w0rxbend/ErgoDox-pcb/hw/ergodox-rp2040/left/ergodox-rp2040-left.kicad_pcb

## KiCad design hw/ergodox-rp2040/left/ergodox-rp2040-left.kicad_pcb (2026-11-14)

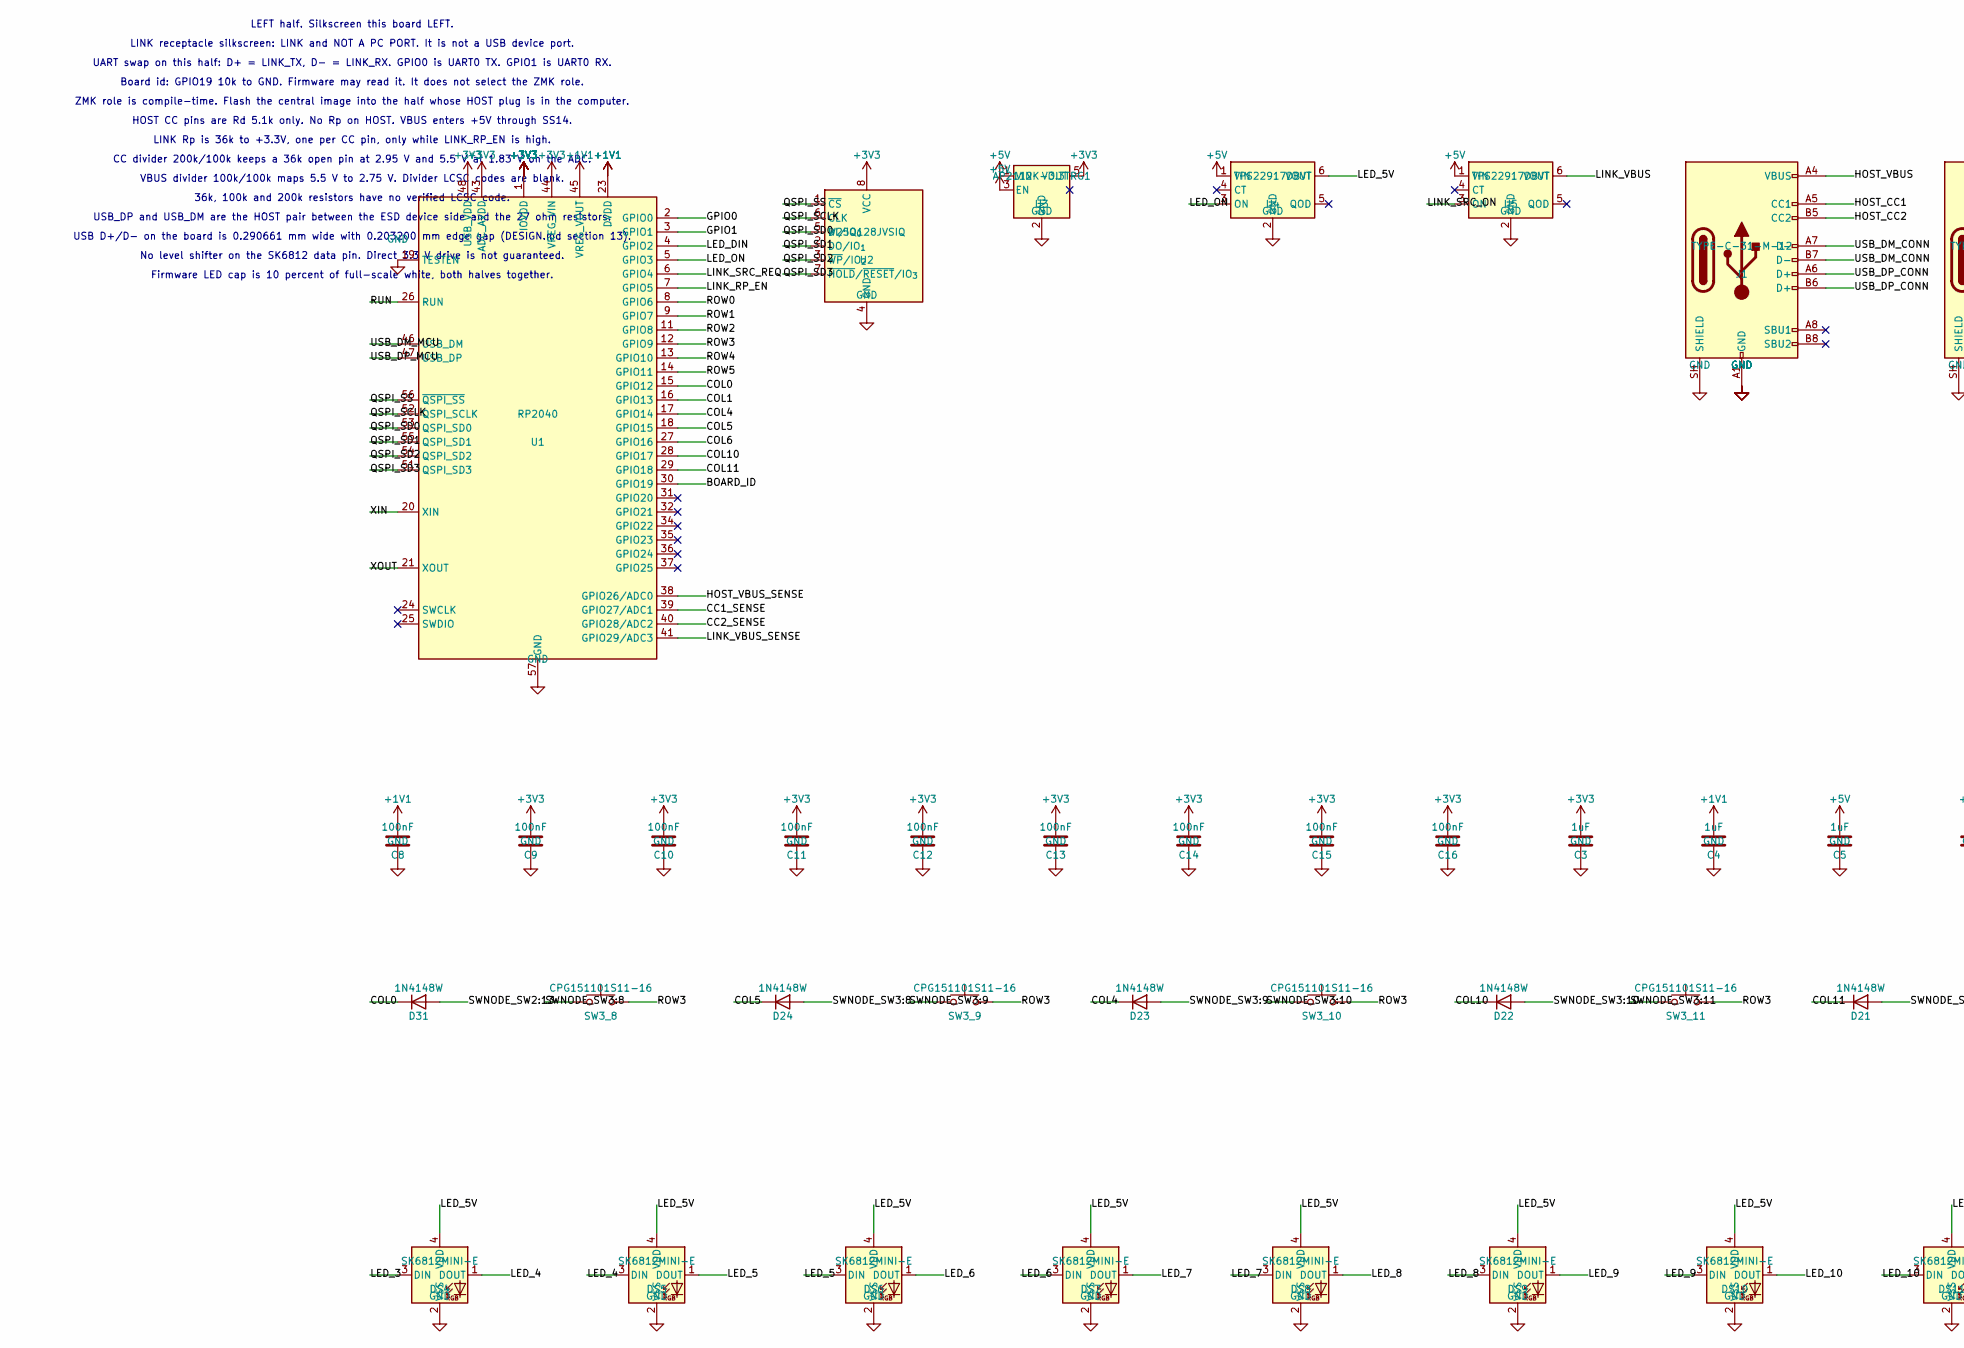
[picture p3: schematic ergodox-rp2040-left.kicad_sch, ErgoDox RP2040 left, part in row 1, column 1]

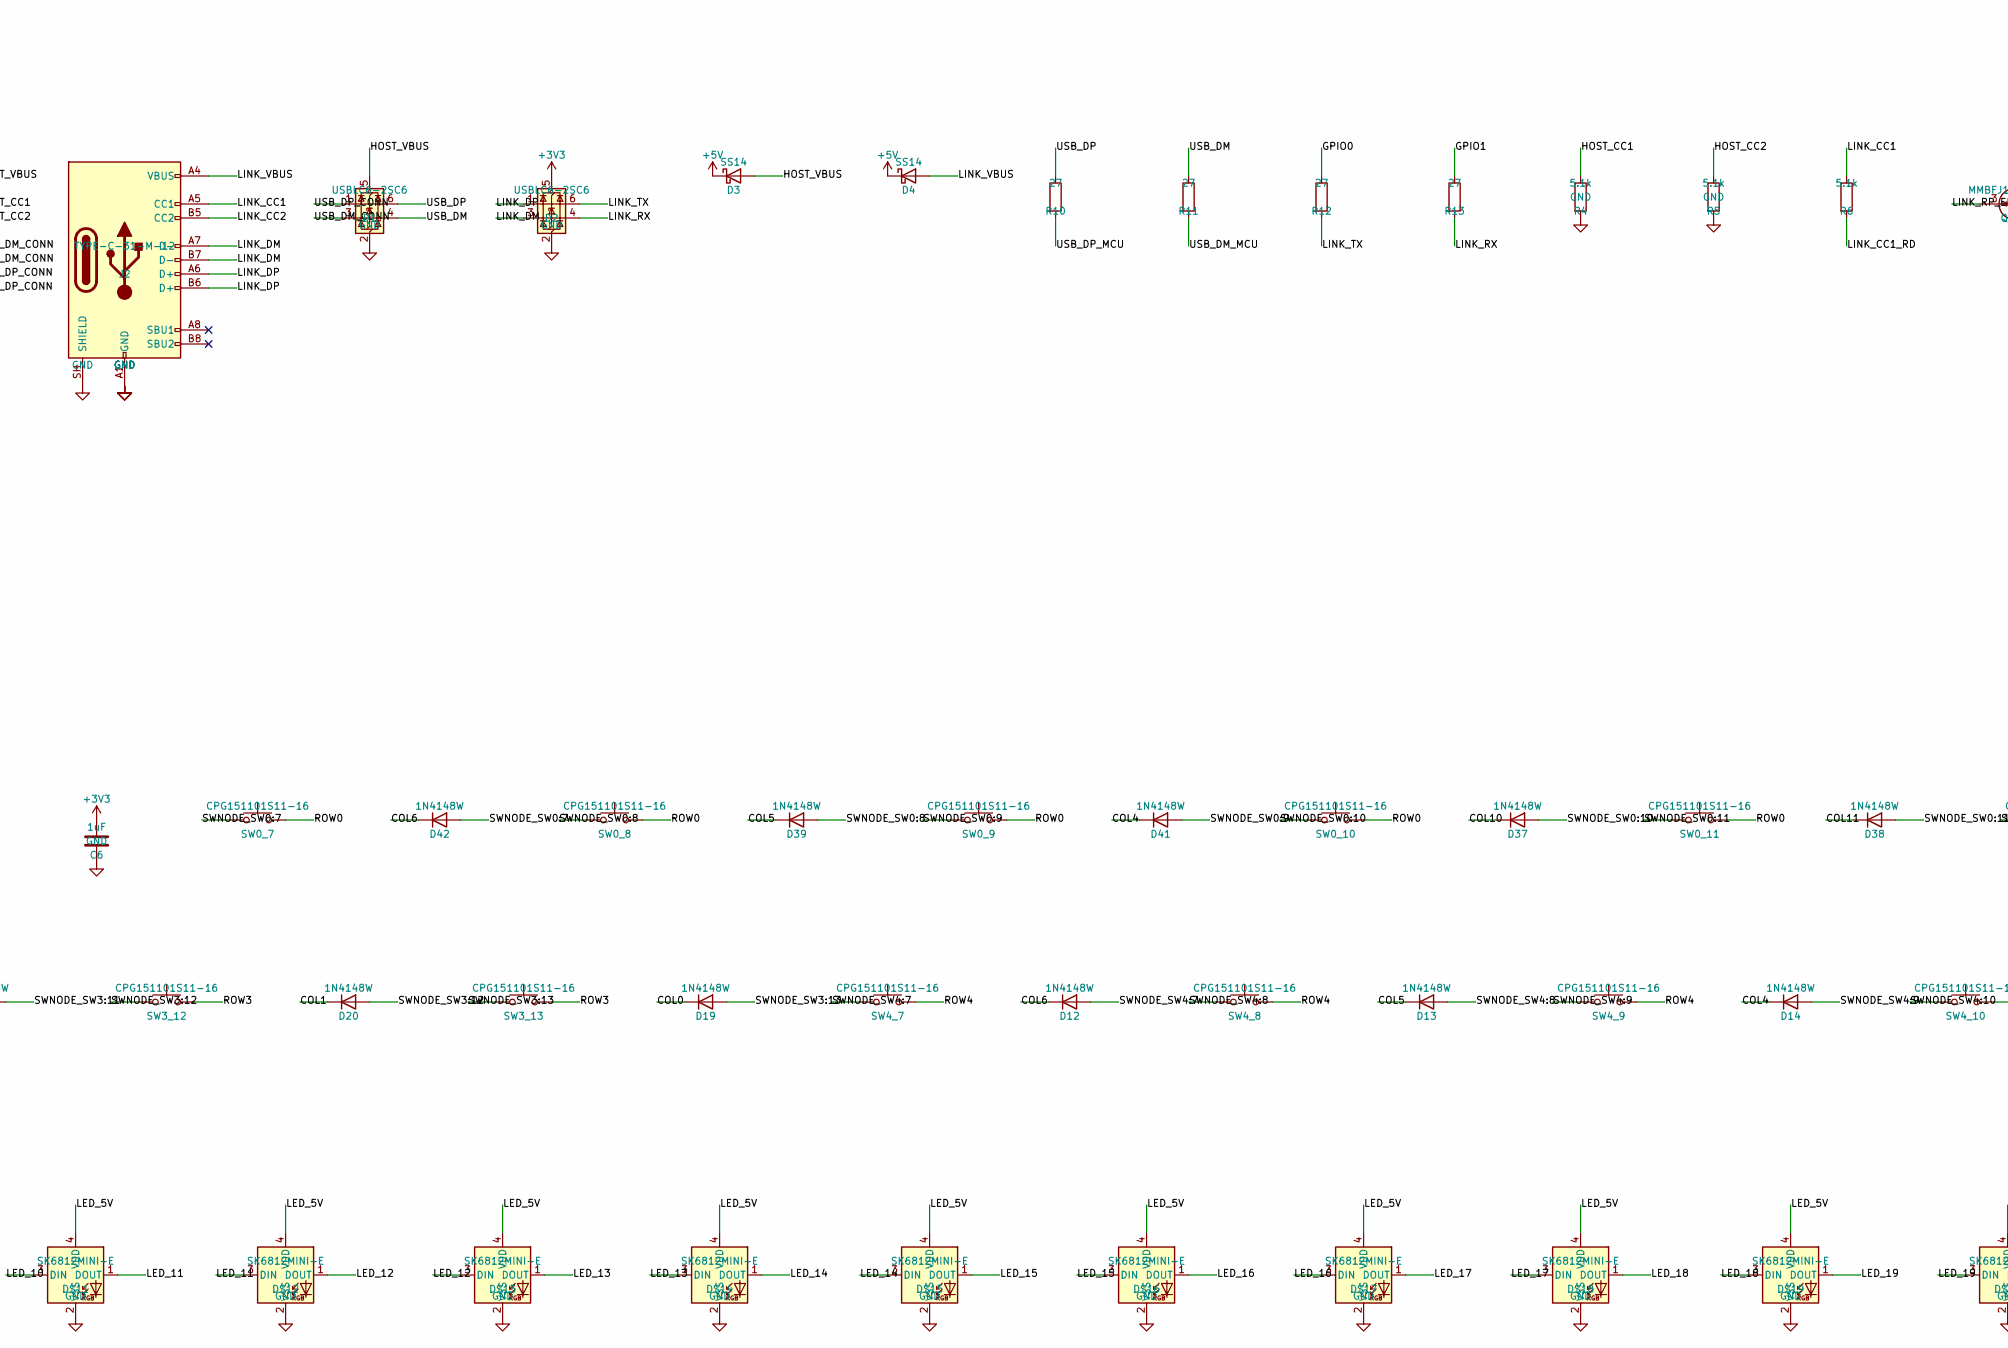
[picture p4: schematic ergodox-rp2040-left.kicad_sch, ErgoDox RP2040 left, part in row 1, column 2]

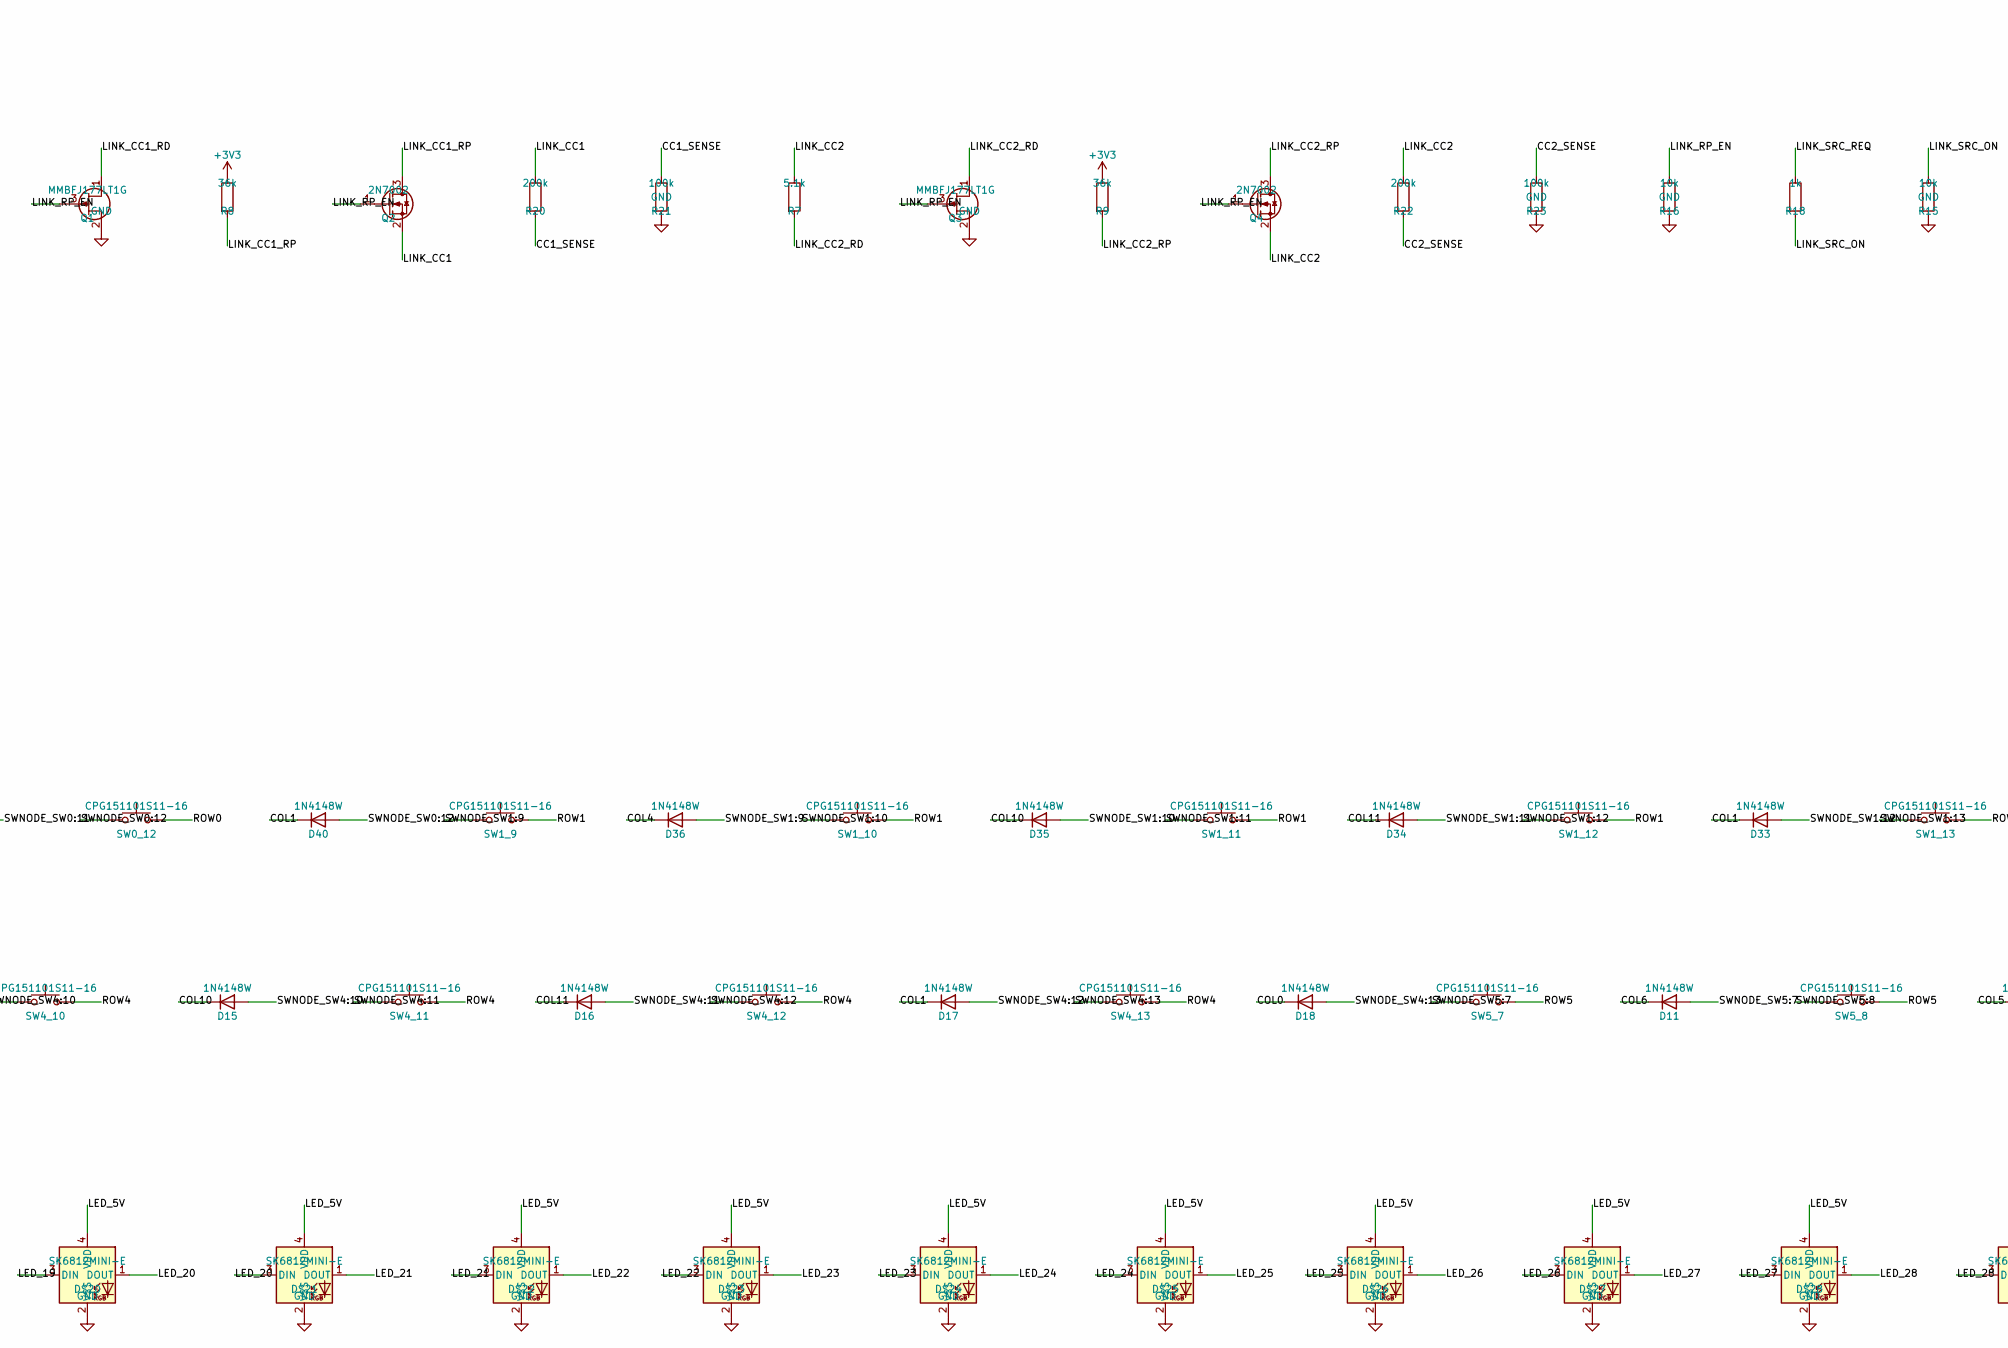
[picture p5: schematic ergodox-rp2040-left.kicad_sch, ErgoDox RP2040 left, part in row 1, column 3]

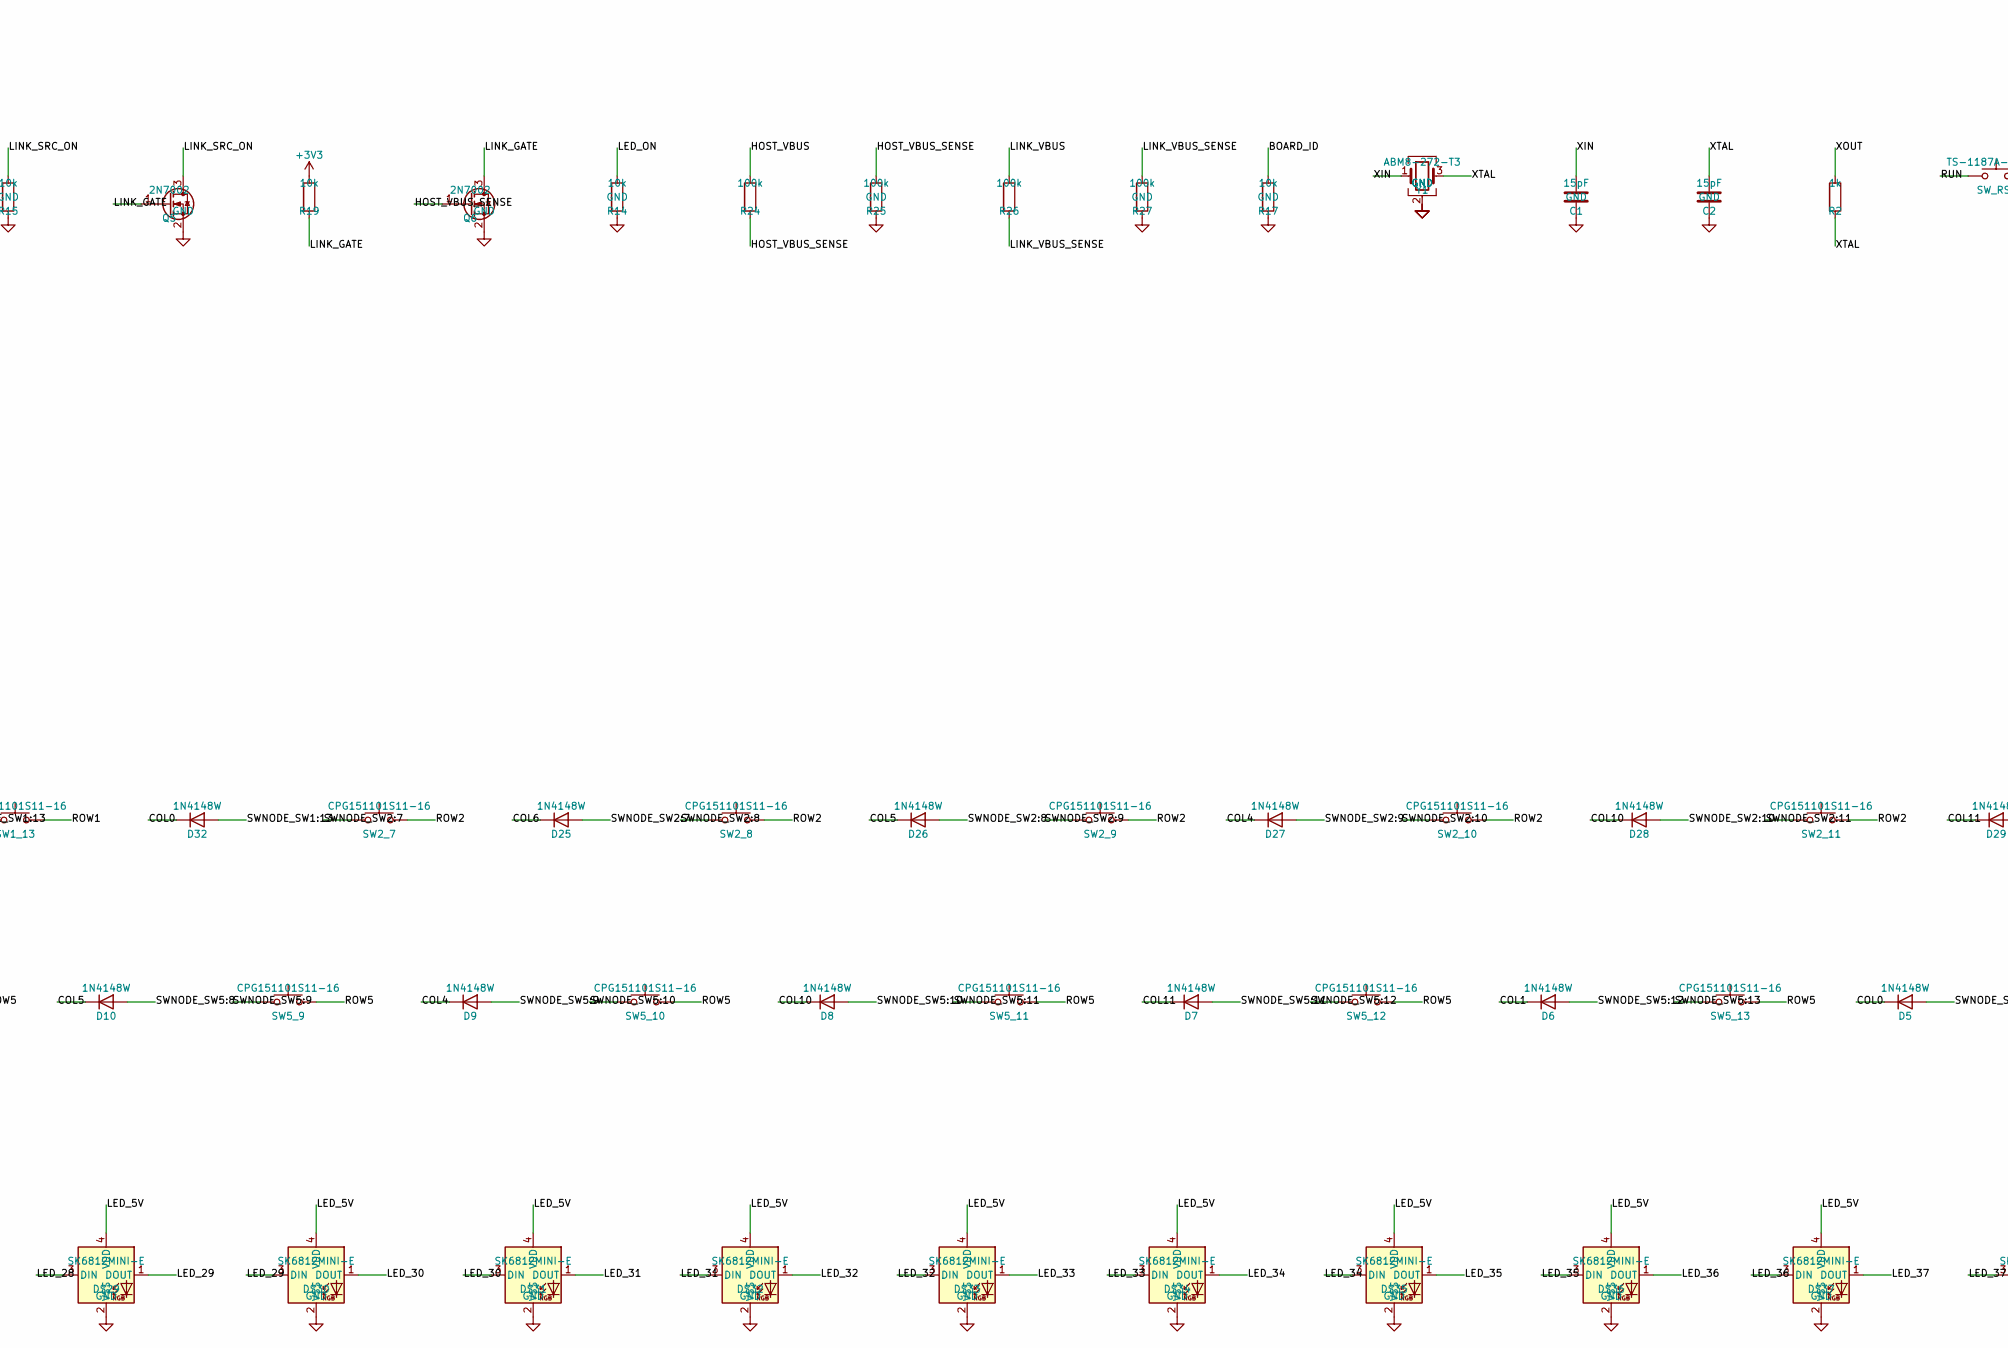
[picture p6: schematic ergodox-rp2040-left.kicad_sch, ErgoDox RP2040 left, part in row 1, column 4]

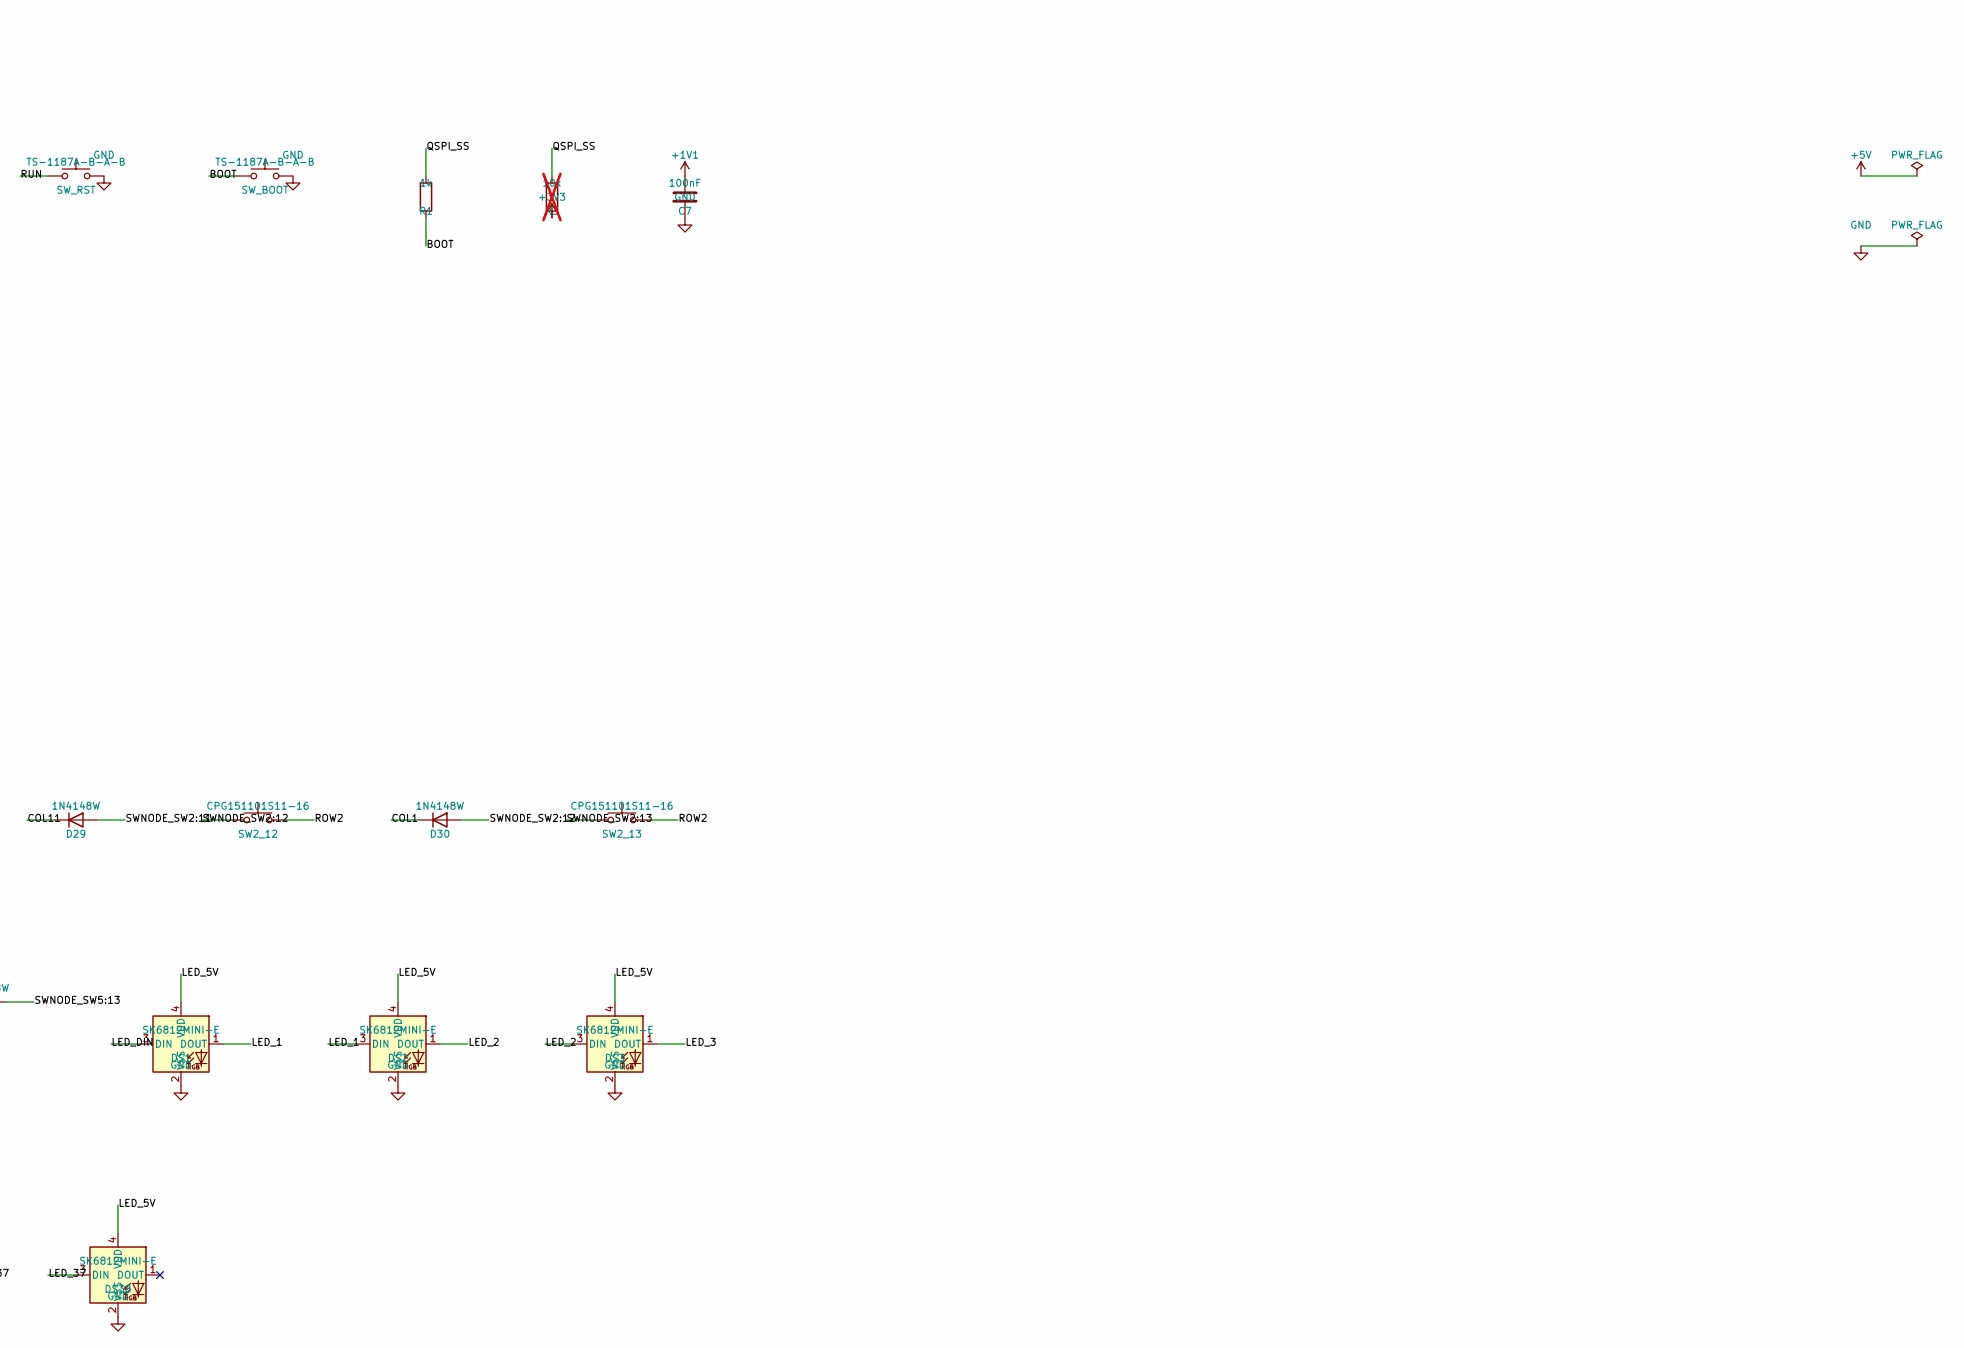
[picture p7: schematic ergodox-rp2040-left.kicad_sch, ErgoDox RP2040 left, part in row 1, column 5]

Parts:
C1, C2: 15pF; C_0402_1005Metric; LCSC C1548
C3, C4, C5, C6: 1uF; C_0402_1005Metric; LCSC C52923
C7, C8, C9, C10, C11, C12, C13, C14, C15, C16: 100nF; C_0402_1005Metric; LCSC C1525
D1, D2: USBLC6-2SC6; SOT-23-6; MPN USBLC6-2SC6; LCSC C7519
D3, D4: SS14; D_SMA; MPN SS14; LCSC C2480
D5, D6, D7, D8, D9, D10, D11, D12, D13, D14, D15, D16, D17, D18, D19, D20, D21, D22, D23, D24, D25, D26, D27, D28, D29, D30, D31, D32, D33, D34, D35, D36, D37, D38, D39, D40, D41, D42: 1N4148W; D_SOD-123; MPN 1N4148W; LCSC C81598
DS1, DS2, DS3, DS4, DS5, DS6, DS7, DS8, DS9, DS10, DS11, DS12, DS13, DS14, DS15, DS16, DS17, DS18, DS19, DS20, DS21, DS22, DS23, DS24, DS25, DS26, DS27, DS28, DS29, DS30, DS31, DS32, DS33, DS34, DS35, DS36, DS37, DS38: SK6812MINI-E; LED_SK6812MINI-E_3.2x2.8mm_P1.5mm_ReverseMount; MPN SK6812MINI-E; LCSC C5149201
J1, J2: TYPE-C-31-M-12; USB_C_Receptacle_HRO_TYPE-C-31-M-12; MPN TYPE-C-31-M-12; LCSC C165948
Q1, Q3: MMBFJ177LT1G; SOT-23; MPN MMBFJ177LT1G; LCSC C106763
Q2, Q4, Q5, Q6: 2N7002; SOT-23; MPN 2N7002; LCSC C8545
R1, R2, R18: 1k; R_0402_1005Metric; LCSC C11702
R3: 10k; R_0402_1005Metric; LCSC C25744; not fitted
R4, R5, R6, R7: 5.1k; R_0402_1005Metric; LCSC C25905
R8, R9: 36k; R_0402_1005Metric
R10, R11, R12, R13: 27; R_0402_1005Metric; LCSC C25100
R14, R15, R16, R17, R19: 10k; R_0402_1005Metric; LCSC C25744
R20, R22: 200k; R_0402_1005Metric
R21, R23, R24, R25, R26, R27: 100k; R_0402_1005Metric
SW0_7, SW0_8, SW0_9, SW0_10, SW0_11, SW0_12, SW1_9, SW1_10, SW1_11, SW1_12, SW1_13, SW2_7, SW2_8, SW2_9, SW2_10, SW2_11, SW2_12, SW2_13, SW3_8, SW3_9, SW3_10, SW3_11, SW3_12, SW3_13, SW4_7, SW4_8, SW4_9, SW4_10, SW4_11, SW4_12, SW4_13, SW5_7, SW5_8, SW5_9, SW5_10, SW5_11, SW5_12, SW5_13: CPG151101S11-16; MX-Hotswap-1U; MPN CPG151101S11-16; LCSC C41430893
SW_BOOT: TS-1187A-B-A-B; SW_Push_1P1T_XKB_TS-1187A; LCSC C318884
SW_RST: TS-1187A-B-A-B; SW_Push_1P1T_XKB_TS-1187A; LCSC C318884
U1: RP2040; QFN-56-1EP_7x7mm_P0.4mm_EP3.2x3.2mm_ThermalVias; MPN RP2040; LCSC C2040
U2: W25Q128JVSIQ; SOIC-8_5.3x5.3mm_P1.27mm; MPN W25Q128JVSIQ; LCSC C97521
U3: AP2112K-3.3TRG1; SOT-23-5; MPN AP2112K-3.3TRG1; LCSC C51118
U4, U5: TPS22917DBVT; SOT-23-6; MPN TPS22917DBVT; LCSC C2680344
Y1: ABM8-272-T3; Crystal_SMD_3225-4Pin_3.2x2.5mm; MPN ABM8-272-T3; LCSC C20625731

Connections:
+1V1: C4.1, C7.1, C8.1, U1.23 (DVDD), U1.45 (VREG_VOUT), U1.50 (DVDD)
+3V3: C3.1, C6.1, C9.1, C10.1, C11.1, C12.1, C13.1, C14.1, C15.1, C16.1, D2.5 (VBUS), R3.2, R8.1, R9.1, R19.1, U1.1 (IOVDD), U1.10 (IOVDD), U1.22 (IOVDD), U1.33 (IOVDD), U1.42 (IOVDD), U1.43 (ADC_AVDD), U1.44 (VREG_VIN), U1.48 (USB_VDD), U1.49 (IOVDD), U2.8 (VCC), U3.5 (VOUT)
+5V: C5.1, D3.1 (K), D4.1 (K), U3.1 (VIN), U3.3 (EN), U4.1 (VIN), U5.1 (VIN)
BOARD_ID: R17.1, U1.30 (GPIO19)
BOOT: R1.2, SW_BOOT.1
CC1_SENSE: R20.2, R21.1, U1.39 (GPIO27/ADC1)
CC2_SENSE: R22.2, R23.1, U1.40 (GPIO28/ADC2)
COL0: D5.1 (K), D18.1 (K), D19.1 (K), D31.1 (K), D32.1 (K), U1.15 (GPIO12)
COL1: D6.1 (K), D17.1 (K), D20.1 (K), D30.1 (K), D33.1 (K), D40.1 (K), U1.16 (GPIO13)
COL4: D9.1 (K), D14.1 (K), D23.1 (K), D27.1 (K), D36.1 (K), D41.1 (K), U1.17 (GPIO14)
COL5: D10.1 (K), D13.1 (K), D24.1 (K), D26.1 (K), D39.1 (K), U1.18 (GPIO15)
COL6: D11.1 (K), D12.1 (K), D25.1 (K), D42.1 (K), U1.27 (GPIO16)
COL10: D8.1 (K), D15.1 (K), D22.1 (K), D28.1 (K), D35.1 (K), D37.1 (K), U1.28 (GPIO17)
COL11: D7.1 (K), D16.1 (K), D21.1 (K), D29.1 (K), D34.1 (K), D38.1 (K), U1.29 (GPIO18)
GND: C1.2, C2.2, C3.2, C4.2, C5.2, C6.2, C7.2, C8.2, C9.2, C10.2, C11.2, C12.2, C13.2, C14.2, C15.2, C16.2, D1.2 (GND), D2.2 (GND), DS1.2 (VSS), DS2.2 (VSS), DS3.2 (VSS), DS4.2 (VSS), DS5.2 (VSS), DS6.2 (VSS), DS7.2 (VSS), DS8.2 (VSS), DS9.2 (VSS), DS10.2 (VSS), DS11.2 (VSS), DS12.2 (VSS), DS13.2 (VSS), DS14.2 (VSS), DS15.2 (VSS), DS16.2 (VSS), DS17.2 (VSS), DS18.2 (VSS), DS19.2 (VSS), DS20.2 (VSS), DS21.2 (VSS), DS22.2 (VSS), DS23.2 (VSS), DS24.2 (VSS), DS25.2 (VSS), DS26.2 (VSS), DS27.2 (VSS), DS28.2 (VSS), DS29.2 (VSS), DS30.2 (VSS), DS31.2 (VSS), DS32.2 (VSS), DS33.2 (VSS), DS34.2 (VSS), DS35.2 (VSS), DS36.2 (VSS), DS37.2 (VSS), DS38.2 (VSS), J1.A1 (GND), J1.A12 (GND), J1.B1 (GND), J1.B12 (GND), J1.SH (SHIELD), J2.A1 (GND), J2.A12 (GND), J2.B1 (GND), J2.B12 (GND), J2.SH (SHIELD), Q1.2 (S), Q3.2 (S), Q5.2 (S), Q6.2 (S), R4.2, R5.2, R14.2, R15.2, R16.2, R17.2, R21.2, R23.2, R25.2, R27.2, SW_BOOT.2, SW_RST.2, U1.19 (TESTEN), U1.57 (GND), U2.4 (GND), U3.2 (GND), U4.2 (GND), U5.2 (GND), Y1.2 (G), Y1.4 (G)
GPIO0: R12.1, U1.2 (GPIO0)
GPIO1: R13.1, U1.3 (GPIO1)
HOST_CC1: J1.A5 (CC1), R4.1
HOST_CC2: J1.B5 (CC2), R5.1
HOST_VBUS: D1.5 (VBUS), D3.2 (A), J1.A4 (VBUS), J1.A9 (VBUS), J1.B4 (VBUS), J1.B9 (VBUS), R24.1
HOST_VBUS_SENSE: Q6.1 (G), R24.2, R25.1, U1.38 (GPIO26/ADC0)
LED_1: DS1.1 (DOUT), DS2.3 (DIN)
LED_2: DS2.1 (DOUT), DS3.3 (DIN)
LED_3: DS3.1 (DOUT), DS4.3 (DIN)
LED_4: DS4.1 (DOUT), DS5.3 (DIN)
LED_5: DS5.1 (DOUT), DS6.3 (DIN)
LED_5V: DS1.4 (VDD), DS2.4 (VDD), DS3.4 (VDD), DS4.4 (VDD), DS5.4 (VDD), DS6.4 (VDD), DS7.4 (VDD), DS8.4 (VDD), DS9.4 (VDD), DS10.4 (VDD), DS11.4 (VDD), DS12.4 (VDD), DS13.4 (VDD), DS14.4 (VDD), DS15.4 (VDD), DS16.4 (VDD), DS17.4 (VDD), DS18.4 (VDD), DS19.4 (VDD), DS20.4 (VDD), DS21.4 (VDD), DS22.4 (VDD), DS23.4 (VDD), DS24.4 (VDD), DS25.4 (VDD), DS26.4 (VDD), DS27.4 (VDD), DS28.4 (VDD), DS29.4 (VDD), DS30.4 (VDD), DS31.4 (VDD), DS32.4 (VDD), DS33.4 (VDD), DS34.4 (VDD), DS35.4 (VDD), DS36.4 (VDD), DS37.4 (VDD), DS38.4 (VDD), U4.6 (VOUT)
LED_6: DS6.1 (DOUT), DS7.3 (DIN)
LED_7: DS7.1 (DOUT), DS8.3 (DIN)
LED_8: DS8.1 (DOUT), DS9.3 (DIN)
LED_9: DS9.1 (DOUT), DS10.3 (DIN)
LED_10: DS10.1 (DOUT), DS11.3 (DIN)
LED_11: DS11.1 (DOUT), DS12.3 (DIN)
LED_12: DS12.1 (DOUT), DS13.3 (DIN)
LED_13: DS13.1 (DOUT), DS14.3 (DIN)
LED_14: DS14.1 (DOUT), DS15.3 (DIN)
LED_15: DS15.1 (DOUT), DS16.3 (DIN)
LED_16: DS16.1 (DOUT), DS17.3 (DIN)
LED_17: DS17.1 (DOUT), DS18.3 (DIN)
LED_18: DS18.1 (DOUT), DS19.3 (DIN)
LED_19: DS19.1 (DOUT), DS20.3 (DIN)
LED_20: DS20.1 (DOUT), DS21.3 (DIN)
LED_21: DS21.1 (DOUT), DS22.3 (DIN)
LED_22: DS22.1 (DOUT), DS23.3 (DIN)
LED_23: DS23.1 (DOUT), DS24.3 (DIN)
LED_24: DS24.1 (DOUT), DS25.3 (DIN)
LED_25: DS25.1 (DOUT), DS26.3 (DIN)
LED_26: DS26.1 (DOUT), DS27.3 (DIN)
LED_27: DS27.1 (DOUT), DS28.3 (DIN)
LED_28: DS28.1 (DOUT), DS29.3 (DIN)
LED_29: DS29.1 (DOUT), DS30.3 (DIN)
LED_30: DS30.1 (DOUT), DS31.3 (DIN)
LED_31: DS31.1 (DOUT), DS32.3 (DIN)
LED_32: DS32.1 (DOUT), DS33.3 (DIN)
LED_33: DS33.1 (DOUT), DS34.3 (DIN)
LED_34: DS34.1 (DOUT), DS35.3 (DIN)
LED_35: DS35.1 (DOUT), DS36.3 (DIN)
LED_36: DS36.1 (DOUT), DS37.3 (DIN)
LED_37: DS37.1 (DOUT), DS38.3 (DIN)
LED_DIN: DS1.3 (DIN), U1.4 (GPIO2)
LED_ON: R14.1, U1.5 (GPIO3), U4.3 (ON)
LINK_CC1: J2.A5 (CC1), Q2.2 (S), R6.1, R20.1
LINK_CC1_RD: Q1.1 (D), R6.2
LINK_CC1_RP: Q2.3 (D), R8.2
LINK_CC2: J2.B5 (CC2), Q4.2 (S), R7.1, R22.1
LINK_CC2_RD: Q3.1 (D), R7.2
LINK_CC2_RP: Q4.3 (D), R9.2
LINK_DM: D2.3 (I/O2), J2.A7 (D-), J2.B7 (D-)
LINK_DP: D2.1 (I/O1), J2.A6 (D+), J2.B6 (D+)
LINK_GATE: Q5.1 (G), Q6.3 (D), R19.2
LINK_RP_EN: Q1.3 (G), Q2.1 (G), Q3.3 (G), Q4.1 (G), R16.1, U1.7 (GPIO5)
LINK_RX: D2.4 (I/O2), R13.2
LINK_SRC_ON: Q5.3 (D), R15.1, R18.2, U5.3 (ON)
LINK_SRC_REQ: R18.1, U1.6 (GPIO4)
LINK_TX: D2.6 (I/O1), R12.2
LINK_VBUS: D4.2 (A), J2.A4 (VBUS), J2.A9 (VBUS), J2.B4 (VBUS), J2.B9 (VBUS), R26.1, U5.6 (VOUT)
LINK_VBUS_SENSE: R26.2, R27.1, U1.41 (GPIO29/ADC3)
QSPI_SCLK: U1.52 (QSPI_SCLK), U2.6 (CLK)
QSPI_SD0: U1.53 (QSPI_SD0), U2.5 (DI/IO_{0})
QSPI_SD1: U1.55 (QSPI_SD1), U2.2 (DO/IO_{1})
QSPI_SD2: U1.54 (QSPI_SD2), U2.3 (~WP/IO_{2})
QSPI_SD3: U1.51 (QSPI_SD3), U2.7 (~HOLD/~RESET/IO_{3})
QSPI_SS: R1.1, R3.1, U1.56 (~QSPI_SS), U2.1 (~CS)
ROW0: SW0_7.2, SW0_8.2, SW0_9.2, SW0_10.2, SW0_11.2, SW0_12.2, U1.8 (GPIO6)
ROW1: SW1_9.2, SW1_10.2, SW1_11.2, SW1_12.2, SW1_13.2, U1.9 (GPIO7)
ROW2: SW2_7.2, SW2_8.2, SW2_9.2, SW2_10.2, SW2_11.2, SW2_12.2, SW2_13.2, U1.11 (GPIO8)
ROW3: SW3_8.2, SW3_9.2, SW3_10.2, SW3_11.2, SW3_12.2, SW3_13.2, U1.12 (GPIO9)
ROW4: SW4_7.2, SW4_8.2, SW4_9.2, SW4_10.2, SW4_11.2, SW4_12.2, SW4_13.2, U1.13 (GPIO10)
ROW5: SW5_7.2, SW5_8.2, SW5_9.2, SW5_10.2, SW5_11.2, SW5_12.2, SW5_13.2, U1.14 (GPIO11)
RUN: SW_RST.1, U1.26 (RUN)
SWNODE_SW0:7: D42.2 (A), SW0_7.1
SWNODE_SW0:8: D39.2 (A), SW0_8.1
SWNODE_SW0:9: D41.2 (A), SW0_9.1
SWNODE_SW0:10: D37.2 (A), SW0_10.1
SWNODE_SW0:11: D38.2 (A), SW0_11.1
SWNODE_SW0:12: D40.2 (A), SW0_12.1
SWNODE_SW1:9: D36.2 (A), SW1_9.1
SWNODE_SW1:10: D35.2 (A), SW1_10.1
SWNODE_SW1:11: D34.2 (A), SW1_11.1
SWNODE_SW1:12: D33.2 (A), SW1_12.1
SWNODE_SW1:13: D32.2 (A), SW1_13.1
SWNODE_SW2:7: D25.2 (A), SW2_7.1
SWNODE_SW2:8: D26.2 (A), SW2_8.1
SWNODE_SW2:9: D27.2 (A), SW2_9.1
SWNODE_SW2:10: D28.2 (A), SW2_10.1
SWNODE_SW2:11: D29.2 (A), SW2_11.1
SWNODE_SW2:12: D30.2 (A), SW2_12.1
SWNODE_SW2:13: D31.2 (A), SW2_13.1
SWNODE_SW3:8: D24.2 (A), SW3_8.1
SWNODE_SW3:9: D23.2 (A), SW3_9.1
SWNODE_SW3:10: D22.2 (A), SW3_10.1
SWNODE_SW3:11: D21.2 (A), SW3_11.1
SWNODE_SW3:12: D20.2 (A), SW3_12.1
SWNODE_SW3:13: D19.2 (A), SW3_13.1
SWNODE_SW4:7: D12.2 (A), SW4_7.1
SWNODE_SW4:8: D13.2 (A), SW4_8.1
SWNODE_SW4:9: D14.2 (A), SW4_9.1
SWNODE_SW4:10: D15.2 (A), SW4_10.1
SWNODE_SW4:11: D16.2 (A), SW4_11.1
SWNODE_SW4:12: D17.2 (A), SW4_12.1
SWNODE_SW4:13: D18.2 (A), SW4_13.1
SWNODE_SW5:7: D11.2 (A), SW5_7.1
SWNODE_SW5:8: D10.2 (A), SW5_8.1
SWNODE_SW5:9: D9.2 (A), SW5_9.1
SWNODE_SW5:10: D8.2 (A), SW5_10.1
SWNODE_SW5:11: D7.2 (A), SW5_11.1
SWNODE_SW5:12: D6.2 (A), SW5_12.1
SWNODE_SW5:13: D5.2 (A), SW5_13.1
USB_DM: D1.4 (I/O2), R11.1
USB_DM_CONN: D1.3 (I/O2), J1.A7 (D-), J1.B7 (D-)
USB_DM_MCU: R11.2, U1.46 (USB_DM)
USB_DP: D1.6 (I/O1), R10.1
USB_DP_CONN: D1.1 (I/O1), J1.A6 (D+), J1.B6 (D+)
USB_DP_MCU: R10.2, U1.47 (USB_DP)
XIN: C1.1, U1.20 (XIN), Y1.1
XOUT: R2.1, U1.21 (XOUT)
XTAL: C2.1, R2.2, Y1.3

Notes on the sheet:
LEFT half. Silkscreen this board LEFT.
LINK receptacle silkscreen: LINK and NOT A PC PORT. It is not a USB device port.
UART swap on this half: D+ = LINK_TX, D- = LINK_RX. GPIO0 is UART0 TX. GPIO1 is UART0 RX.
Board id: GPIO19 10k to GND. Firmware may read it. It does not select the ZMK role.
ZMK role is compile-time. Flash the central image into the half whose HOST plug is in the computer.
HOST CC pins are Rd 5.1k only. No Rp on HOST. VBUS enters +5V through SS14.
LINK Rp is 36k to +3.3V, one per CC pin, only while LINK_RP_EN is high.
CC divider 200k/100k keeps a 36k open pin at 2.95 V and 5.5 V at 1.83 V on the ADC.
VBUS divider 100k/100k maps 5.5 V to 2.75 V. Divider LCSC codes are blank.
36k, 100k and 200k resistors have no verified LCSC code.
USB_DP and USB_DM are the HOST pair between the ESD device side and the 27 ohm resistors.
USB D+/D- on the board is 0.290661 mm wide with 0.203200 mm edge gap (DESIGN.md section 13).
No level shifter on the SK6812 data pin. Direct 3.3 V drive is not guaranteed.
Firmware LED cap is 10 percent of full-scale white, both halves together.
