w0rxbend/ErgoDox-pcb/hw/ergodox-rp2040/left/ergodox-rp2040-left.kicad_pcb

## KiCad design hw/ergodox-rp2040/left/ergodox-rp2040-left.kicad_pcb (continued)

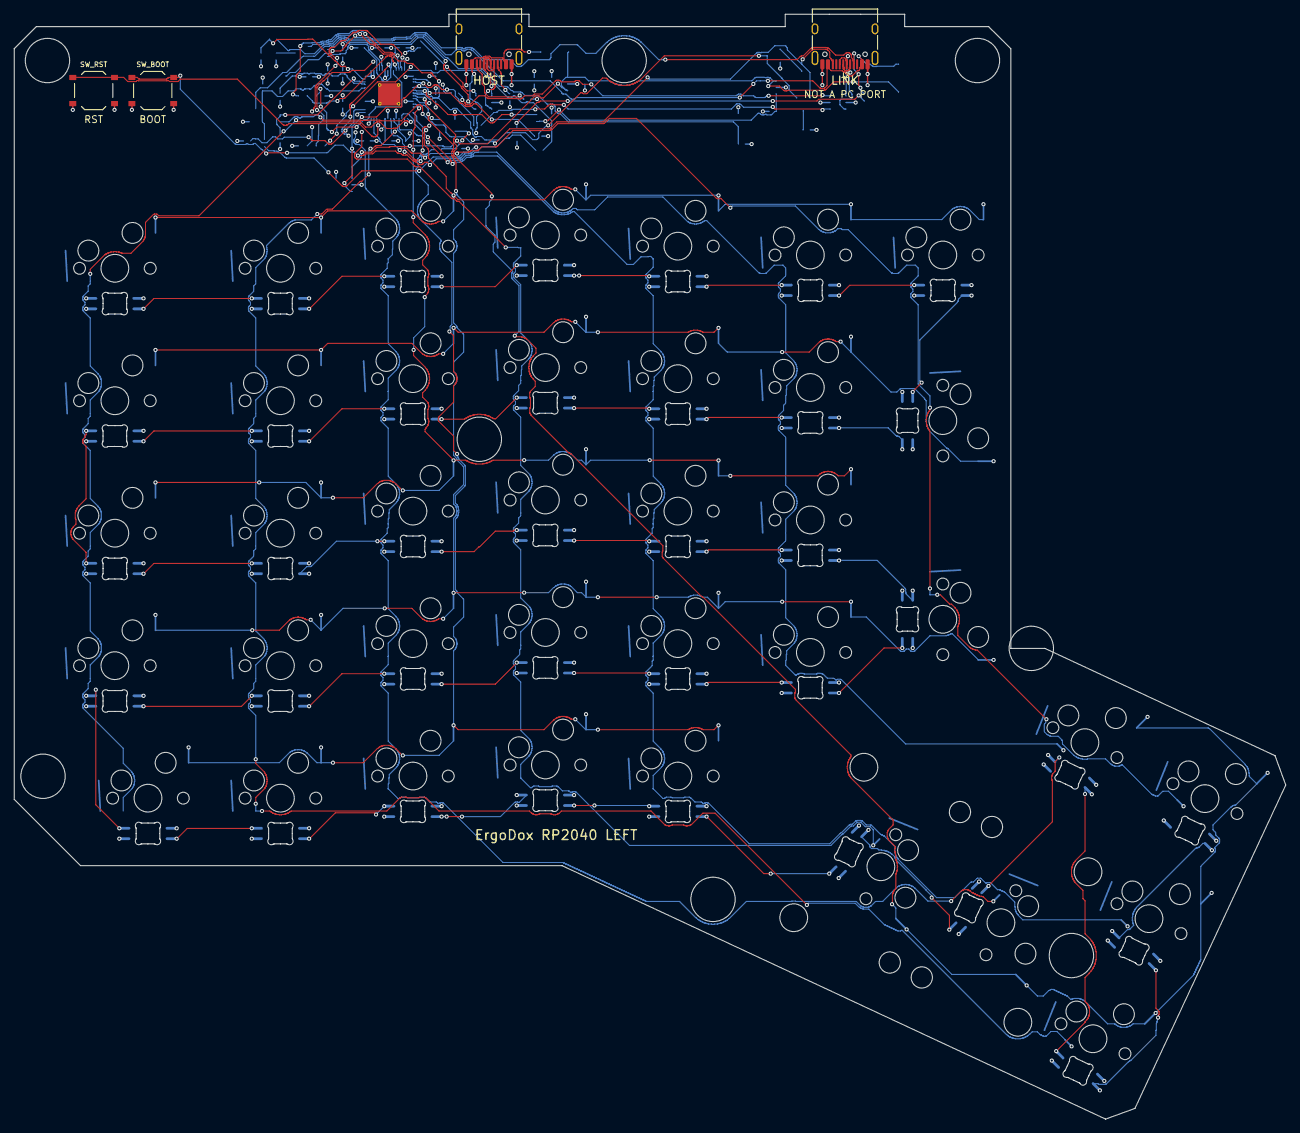
[picture p8: board ergodox-rp2040-left.kicad_pcb from above]

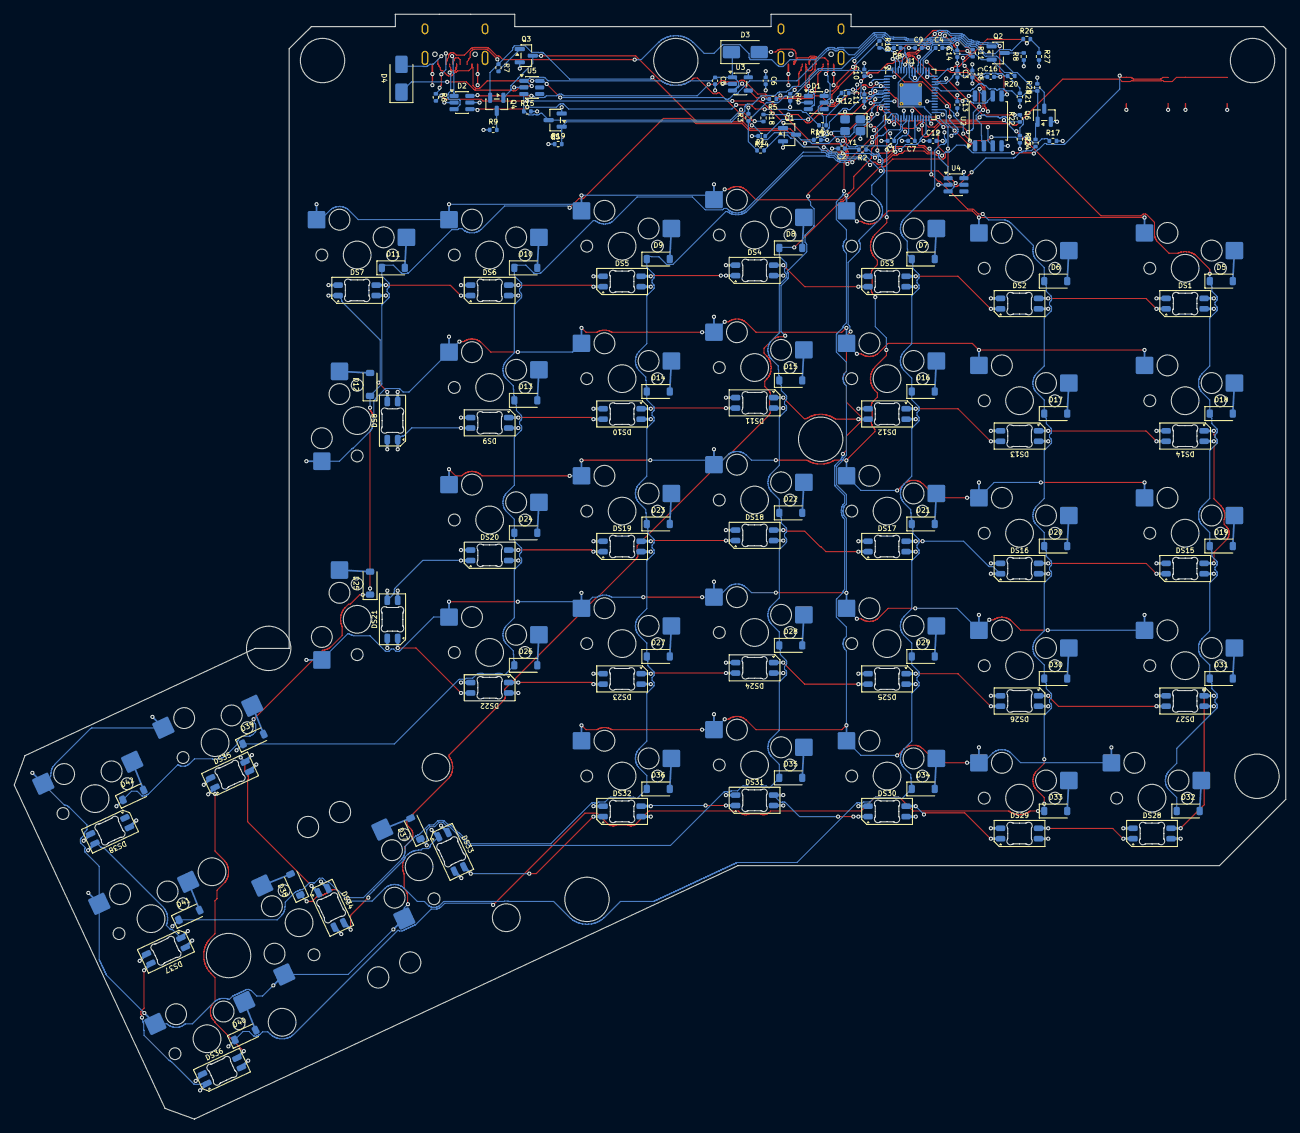
[picture p9: board ergodox-rp2040-left.kicad_pcb from below]

Board: 4 copper layers, 182.8 x 158.9 mm, 187 parts (173 on the bottom side), 137 nets.

Other parts of the board:
H1: NPTH; NPTH_H1
H2: NPTH; NPTH_H2
H3: NPTH; NPTH_H3
H4: NPTH; NPTH_H4
H5: NPTH; NPTH_H5
H6: NPTH; NPTH_H6
H7: NPTH; NPTH_H7
H8: NPTH; NPTH_H8
S1: NPTH; NPTH_S1
S2: NPTH; NPTH_S2
