w0rxbend/ErgoDox-pcb/(commit log)

2026-11-08 Add the in-progress ErgoDox RP2040 USB-C design.
    Schematics pass ERC. The left and right boards are placed and partly routed, with open nets, DRC errors, and no zone pours. PLAN.md records how to continue. Not ready to fabricate.
    [ergodox-rp2040-left.kicad_pcb, ergodox-rp2040-left.kicad_sch, ergodox-rp2040-right.kicad_pcb, ergodox-rp2040-right.kicad_sch, overlap.kicad_pcb]
2026-11-12 Rebuild the RP2040 boards so they can be assembled.
    The earlier boards had faults that no amount of routing could fix: sockets
    on the switch side, overlapping thumb sockets, USB-C receptacles facing
    into the board, mirrored chip footprints on the left half, transistors
    with no nets, and LEDs facing away from the keys.
    The generator now places 38 keys per half with sockets, diodes, reverse-
    mount SK6812MINI-E LEDs and the controller on the back. Both placements
    pass DRC with 0 errors. Routing moves to Freerouting; the home-made maze
    router is deleted. tools/build.sh runs the whole flow.
    Routing is not finished, so the committed boards are placed but unrouted.
    PLAN.md lists the open work. No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
    [ergodox-rp2040-left.kicad_pcb, ergodox-rp2040-left.kicad_sch, ergodox-rp2040-right.kicad_pcb, ergodox-rp2040-right.kicad_sch, overlap.kicad_pcb]
2026-11-12 Add a project page and rewrite the README.
    The README described the 2016 board only. It now covers the RP2040
    design, how to rebuild the boards, the firmware images and known limits.
    docs/index.html is a single-file page for GitHub Pages. It states that
    the boards are in development and have not been fabricated.
2026-11-12 Tie power to the planes and pre-wire each key cell.
    Freerouting only connects plane nets through its fanout stage, and that
    stage puts a via on every SMD pin, which chokes the RP2040. It also
    cannot reach the rotated thumb sockets.
    place.py now adds a plane via for every GND, +3V3 and LED_5V pad, the
    socket-to-diode track and a row stub in each key cell. The router runs
    without fanout and only has signals left. Six pulldowns on unused GPIO
    are removed; firmware uses the internal ones.
    Both boards pass DRC with 0 errors and all three plane nets connected.
    201 signal connections per board are still unrouted.
    [ergodox-rp2040-left.kicad_pcb, ergodox-rp2040-left.kicad_sch, ergodox-rp2040-right.kicad_pcb, ergodox-rp2040-right.kicad_sch]
2026-11-12 Add board renders and keep fixed copper clear for the router.
    The README now shows front and back renders of both halves and how to
    make them again.
    Freerouting refuses to route near copper that breaks its own rules. Its
    rule check counted 65 violations on the plane vias, each 0.1 mm from a
    pad of its own net. Vias now keep 0.19 mm from every pad, and the two
    RP2040 corner pins that had no plane via get one through an elbow stub.
    Both placed boards pass KiCad DRC and the router's rule check with 0
    errors. Signal routing is still open.
    [ergodox-rp2040-left.kicad_pcb, ergodox-rp2040-left.kicad_sch, ergodox-rp2040-right.kicad_pcb, ergodox-rp2040-right.kicad_sch]
2026-11-13 Add vias beside LED data pads and at the row stubs.
    The router cannot land on pads rotated 25 degrees in the thumb cluster.
    A via is round, so it can. Each LED pad and each row stub now ends in a
    fixed via. Row vias move aside when they would sit in the screw-head
    area of a mounting hole.
    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
    [ergodox-rp2040-left.kicad_pcb, ergodox-rp2040-left.kicad_sch, ergodox-rp2040-right.kicad_pcb, ergodox-rp2040-right.kicad_sch]
2026-11-13 Turn LEDs down the chain and add a rip-up router for open nets.
    Freerouting 1.9.0 and 2.5.0 both stall with 10 to 28 connections open
    per board. Three causes were in the placement:
    - An LED whose data output faced away from the next LED needed a link
    round its own body, and the router never found one. Each LED now
    turns to face down the chain.
    - The router does not pick up a fixed stub that lies at an odd angle,
    which was every stub in the thumb cluster. Stubs now run at multiples
    of 45 degrees, and a turned diode gets a via stub on its column pad.
    - Decoupling parts sat against the RP2040 pins. A 1 mm band round the
    package now stays free of parts.
    tools/finish.py routes the pai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
    [ergodox-rp2040-left.kicad_pcb, ergodox-rp2040-left.kicad_sch, ergodox-rp2040-right.kicad_pcb, ergodox-rp2040-right.kicad_sch]
2026-11-13 Route with 0.1 mm signal tracks and a self-checking finisher.
    At 0.15 mm tracks and gaps no router got out of the RP2040: Freerouting
    stalled at 10 to 28 open connections per board, and the grid router at 6
    to 15. JLCPCB lists 0.09 mm track and gap as the 4-layer minimum, so the
    signal rules drop to 0.1 mm. Power and USB keep their class widths.
    finish.py changes:
    - It keeps its own record of the link each route makes. KiCad's
    connectivity query broke the Python objects after a few calls, so it
    is not used, and track and via outlines are plain geometry.
    - Only routes laid in the same run may be pushed aside. Pushing older
    copper piece by piece broke more links than it made.
    - One rou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
    [ergodox-rp2040-left.kicad_pcb, ergodox-rp2040-left.kicad_sch, ergodox-rp2040-right.kicad_pcb, ergodox-rp2040-right.kicad_sch]
2026-11-13 Keep each RP2040 pin's way out free while routing.
    With 0.1 mm rules one round left 2 links open on the right board and 4
    on the left, all at the controller. Routes of other nets crossed right
    in front of a pin and walled it in. Each signal pin now gets a 1.2 mm
    lane straight out from its pad that only its own net may use.
    A router via under the package also cut the inner +3V3 plane round the
    power vias there, leaving one of them as an island. Router vias now stay
    out from under the package.
    The effect is not measured yet: the routing run with this change is
    still going. The committed boards stay placed, with fixed copper only.
    [finish.py]
2026-11-13 Space parts 1 mm apart and give the router a second pass.
    With 0.1 mm rules every run leaves 2 to 6 links open per board, all
    from an RP2040 pin to a part 30 to 70 mm away. Ordering does not fix
    it, so this gives the routes more room:
    - place.py keeps 1.0 mm between part courtyards instead of 0.5 mm,
    room for three 0.1 mm tracks. Both boards still place, and every
    power pad now gets its plane via.
    - finish.py keeps router vias 1.1 mm from plane vias. A ring of router
    vias cut the inner +3V3 plane round a power via and left it as an
    island.
    - finish.py runs a second pass with the links the first gave up at the
    front, and keeps whichever pass leaves fewer open. On the old
    placemen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
    [ergodox-rp2040-left.kicad_pcb, ergodox-rp2040-left.kicad_sch, ergodox-rp2040-right.kicad_pcb, ergodox-rp2040-right.kicad_sch]
2026-11-14 Start the LED chain beside the controller and move U4 next to it.
    The old chain began at the far end of the board, so LED_DIN and
    LED_ON crossed the whole controller corner and blocked RP2040 escapes.
    Index 1 is now the top-row key beside the controller; the chain snakes
    down the rows and ends in the thumb cluster. U4 sits in the LED_5V
    pour beside the chip, so LED_ON is short.
    The finisher may now run tracks on In2 inside the +3V3 pour, and it
    prints progress every 25 links. The pin check no longer flags the
    unwired clk/miso tags of the LED SPI driver.
    Both boards: 0 DRC errors, schematic parity clean, 199 of 201 links.
    Still open: right ROW3 (U1 pin 12) and COL0 (U1 pin 15); left ROW4
    (U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
    [ergodox-rp2040-left.kicad_pcb, ergodox-rp2040-left.kicad_sch, ergodox-rp2040-right.kicad_pcb, ergodox-rp2040-right.kicad_sch]
2026-11-14 Route each net at its class width and drop Freerouting from the build.
    The boards carried +5V, VBUS and the USB pair on 0.1 mm tracks, as
    finish.py laid every net at the signal width. It now reads the netclass
    widths from the project file (Power 0.4 mm, USB 0.2907 mm), routes those
    nets first, and lays 0.1 mm only where a wide track finds no way
    through, naming those nets in its summary.
    build.sh now runs build_board.py, DRC, finish.py and DRC; Freerouting
    stalled at 10 to 28 open links and route.py is deleted. export_fab.sh
    is new and writes the JLCPCB Gerber zip, BOM and CPL. README follows.
    Not yet run: finish.py with widths, build.sh and export_fab.sh. The
    committed boards still have t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
    [finish.py]
